abdurrahmanaydin5858/PCB/README.md

# PCB
PCB_PROJECTS
The repo is about to my currrent and past projecy repo.
