abdurrahmanaydin5858/PCB/CONTROLBOARD(FAZ2)/Project Input/BLOCK.PNG

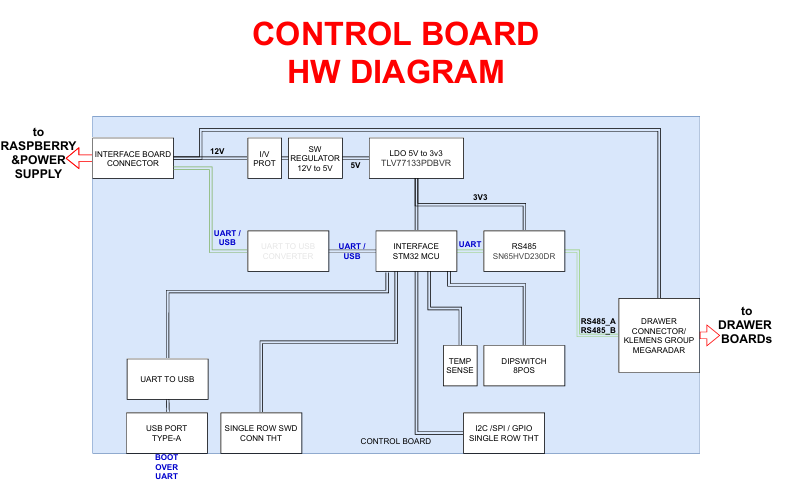
CONTROLBOARD(FAZ2)/Project Input/BLOCK.PNG
