abdurrahmanaydin5858/PCB/CONTROLBOARD(FAZ2)/Project Input/diagram.png

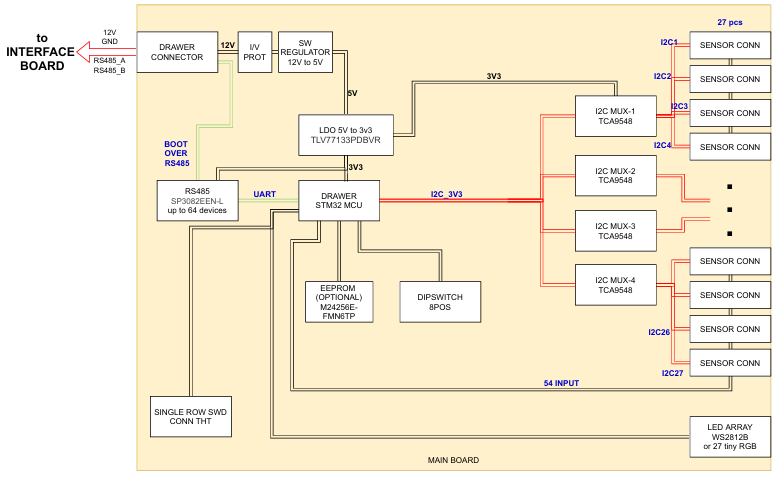
CONTROLBOARD(FAZ2)/Project Input/diagram.png
