abdurrahmanaydin5858/PCB/CONTROLBOARD(FAZ2)/Project Input/TCA_ADDRESS.PNG

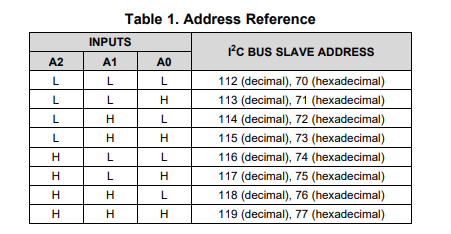
CONTROLBOARD(FAZ2)/Project Input/TCA_ADDRESS.PNG
