abdurrahmanaydin5858/PCB/CONTROLBOARD(FAZ2)/Project Input/TMP100.PNG

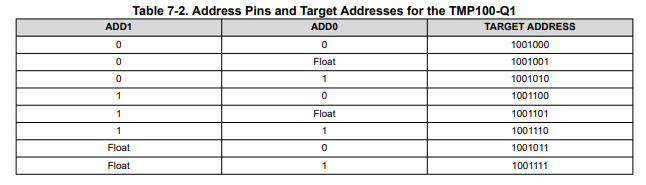
CONTROLBOARD(FAZ2)/Project Input/TMP100.PNG
