abdurrahmanaydin5858/PCB/MAINBOARD(FAZ2)/Production Files/Assembly/BOM_MAINBOARD.xlsx

Quantity | Designator | Part Number | Description
84 | R1, R2, R3, R4, R6, R8, R10, R11, R12, R13, R14, R15, R16, R18, R20, R22, R23, R24, R25, R26, R27, R28, R30, R32, R34, R35, R36, R37, R38, R39, R40, R42, R44, R46, R47, R48, R49, R50, R51, R52, R54, R56, R58, R59, R60, R61, R62, R63, R64, R66, R68, R70, R71, R72, R73, R74, R75, R76, R78, R80, R82, R83, R84, R85, R86, R87, R88, R90, R92, R94, R95, R96, R97, R98, R99, R100, R102, R104, R106, R107, R108, R147, R148, R158 | RMCF0402JT220R | Generic Chip Res 220R
51 | C1, C2, C3, C4, C8, C10, C12, C14, C16, C17, C18, C19, C20, C22, C23, C24, C25, C26, C27, C28, C29, C32, C33, C34, C40, C41, C42, C43, C44, C45, C46, C47, C48, C49, C50, C51, C52, C53, C54, C55, C56, C57, C58, C59, C60, C61, C62, C63, C64, C65, C66 | CL05B104KP5NNNC | 100nF 0402 Ceramic Capacitor
35 | R110, R112, R114, R115, R117, R119, R121, R123, R125, R127, R128, R130, R134, R135, R136, R137, R138, R139, R140, R141, R142, R143, R144, R145, R146, R149, R160, R161, R162, R163, R164, R165, R166, R167, R168 | RMCF0402JT2K20 | Generic Chip Res 2k2
28 | J1, J2, J3, J4, J5, J6, J7, J8, J9, J10, J11, J12, J13, J14, J15, J16, J17, J18, J19, J20, J21, J22, J23, J24, J25, J26, J27, J_BOS | 009159006651906 | CONN EDGE DUAL FMALE 6POS 0.024
28 | Q1, Q2, Q3, Q4, Q5, Q6, Q7, Q8, Q9, Q10, Q11, Q12, Q13, Q14, Q15, Q16, Q17, Q18, Q19, Q20, Q21, Q22, Q23, Q24, Q25, Q26, Q27, Q28 | GSF3407 | P-Channel 30 V 4.1A (Ta) 1.2W (Ta) Surface Mount SOT-23
28 | R5, R7, R9, R17, R19, R21, R29, R31, R33, R41, R43, R45, R53, R55, R57, R65, R67, R69, R77, R79, R81, R89, R91, R93, R101, R103, R105, R153 | RMCF0402JT100K | Generic Chip Res 158k
27 | LED1, LED2, LED3, LED4, LED5, LED6, LED7, LED8, LED9, LED10, LED11, LED12, LED13, LED14, LED15, LED16, LED17, LED18, LED19, LED20, LED21, LED22, LED23, LED24, LED25, LED26, LED27 | IN-PI22TAT5R5G5B | ADDRESS LED DISCRETE SERIAL RGB
7 | C5, C6, C7, C9, C11, C13, C15 | CL10A225KP8NNNC | 2.2uF 0603 Ceramic Capacitor
4 | U1, U2, U3, U4 | TCA9548APWR | IC BUS SWITCH 1 X 8:1 24TSSOP
3 | C35, C38, C39 | CL21A106KOQNNNE | 10uF 0805 Ceramic Capacitor
3 | D4, D5, D6 | HSMM-C170
3 | R152, R155, R157 | RMCF0402FT3K00 | Generic Chip Res 3k0
2 | C21, C37 | CL10A475KP8NNNC | 4,7uF 0603 Ceramic Capacitor
2 | C30, C31 | CC0402JRNPO9BN180 | 18pF 0402 Ceramic Capacitor
2 | D1, D2 | SMF16CA | Unidirectional TVS DIODE 200W 16V-17.8V SOD-123
2 | J_EXTRA, PROG | 125SH-B-05-TS | CONN HEADER VERT 5POS 1.25MM
1 | C36 | CC0402JRNPO9BN101 | 100pF 0402 Ceramic Capacitor
1 | D3 | SMF13A | TVS DIODE 200W 14.4V-15.9V SOD-123
1 | DEVICE_ID | 219-8LPST | Dip Switch SPST 8 Position Surface Mount Slide (Standard) Actuator 100mA 20VDC
1 | INPUT | B4B-XH-A | CONN HEADER VERT 4POS 2.5MM
1 | L1 | MPZ1608S221ATA00 | Generic SMD IND/BEAD
1 | L2 | BMRB00060630100MA1 | FIXED IND 10UH 4A 68 MOHM SMD
1 | R150 | MF72-005D9 | Inrush Current Limiter 5 Ohms ±20% 3 A
1 | R151 | RMCF0402FT158K | Generic Chip Res 158k
1 | R154 | RMCF0402JT30K0 | Generic Chip Res 30k
1 | R156 | RMCF0402FT2K00 | Generic Chip Res 2k0
1 | U5 | STM32H563ZIT6 | ARM® Cortex®-M33 STM32H5 Microcontroller IC 32-Bit 250MHz 2MB (2M x 8) FLASH 144-LQFP (20x20) )
1 | U6 | M24256E-FMN6TP | IC EEPROM 256KBIT I2C 1MHZ 8SO
1 | U7 | SP3082EEN-L | 1/1 Transceiver Half RS422, RS485 8-SOIC
1 | U8 | AP63200WU-7 | IC REG BUCK ADJ 2A TSOT23-6 3.8V to 32V
1 | U9 | AMS1117-ADJ | IC LDO REG ADJ 1A SOT223
