abdurrahmanaydin5858/PCB/CONTROLBOARD(FAZ2)/finalRevisions_kb.txt

1- Boyut 10x10 (EMT ile check edilecek)   tamamlandı
2- 4 X rs485 portları :  Megaradar 14.204 MODEL TERMİNAL BLOCK 
3- 1 adet POWER PORT : Megaradar 12.353 3 pin
4- 1 adet USB PORT : CONNFLY RA Dişi
5- 6 pinli ALARM PORT : 6 pinli MEGARADAR. 1,2,3 HS SW (12V250ma). 4 -> V(-)
6- Montaj delikleri merkezden 5.2mm uzaklıkta 4 / 6    -------eklendi 6. eklenen çok mantıklı gelmedi yer kalmayacak gibi?
7- Dizgi tek tarafta olacak
8- Giriş Çıkışlara korumalar ------eklenecek eklendi  output koruması yok
9- Alarm güçleri dısarıdan gelecek. sadece anahtarlama yapılacak -----  eklendi koruma nasıl olacak sadece giriş mi? 
10- EEPROM eklenecek -------(var zaten ne ile değişecek)   mainboard daki ile aynı

11- İşlemci : STM32F405RGT6 olacak (değiştirildi)
12- Extra Service Uart ve I2C portu olacak  -------- yarın bakılacak
13- Sistemle haberleşme icin yedek olarak UART portu olacak (MEGARADAR 3-4 pin)( yedek UART hattı pek mümkün görünmüyor.)
