abdurrahmanaydin5858/PCB/CONTROLBOARD(FAZ2)/CONTROLBAORD.pdf

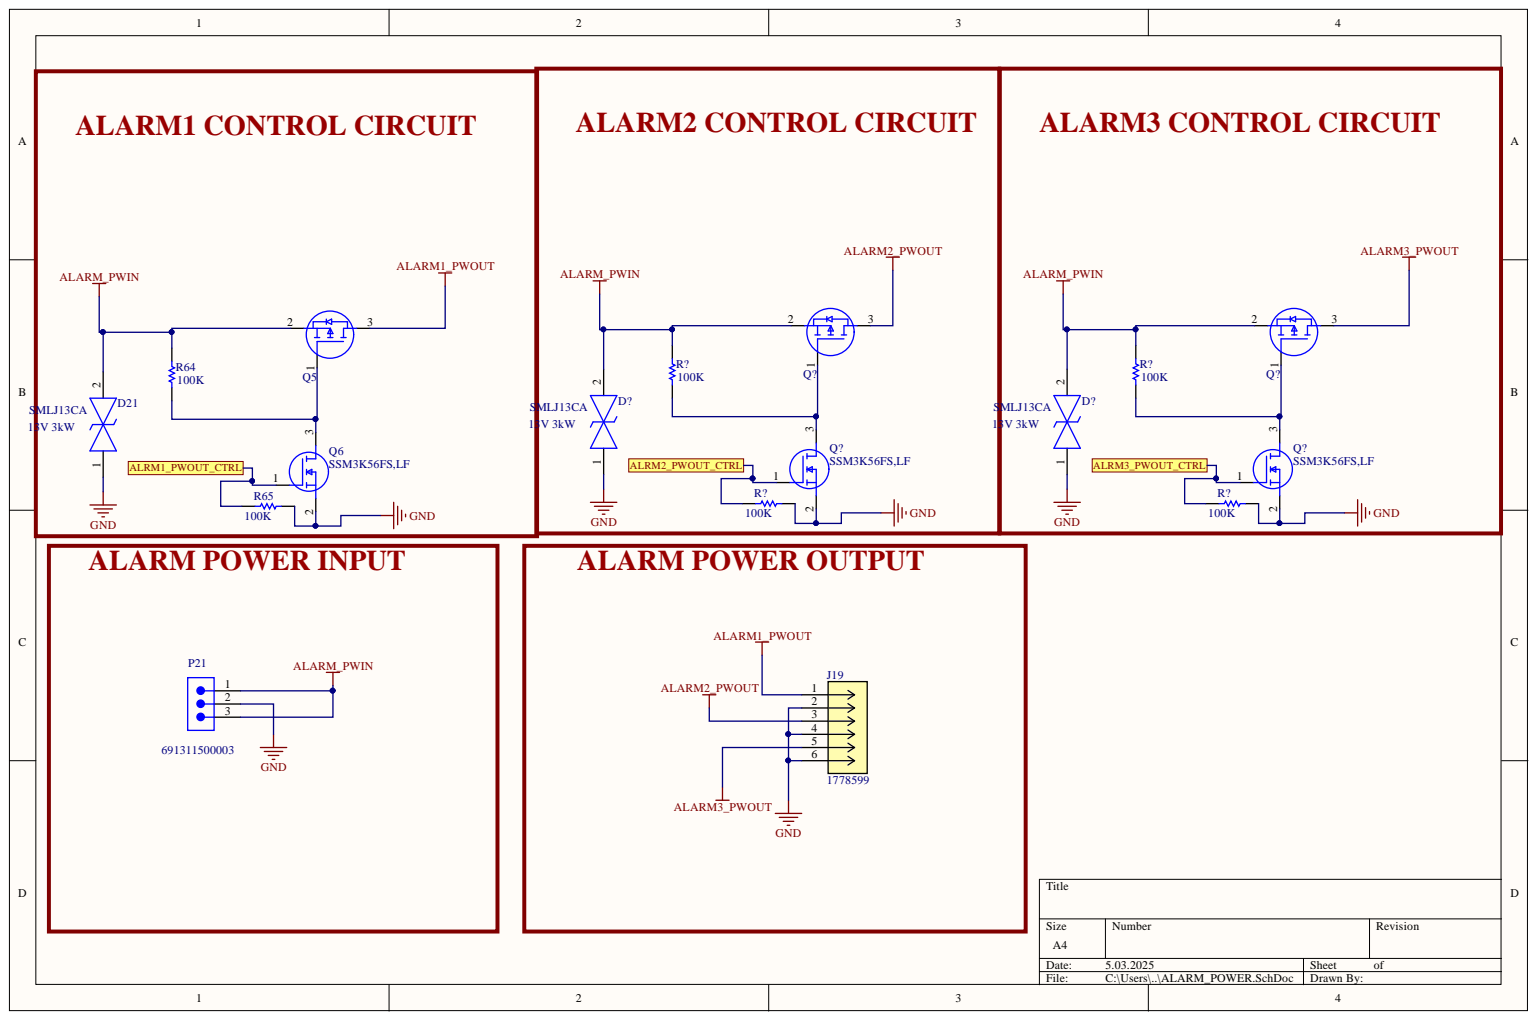
[picture p7: page 1]

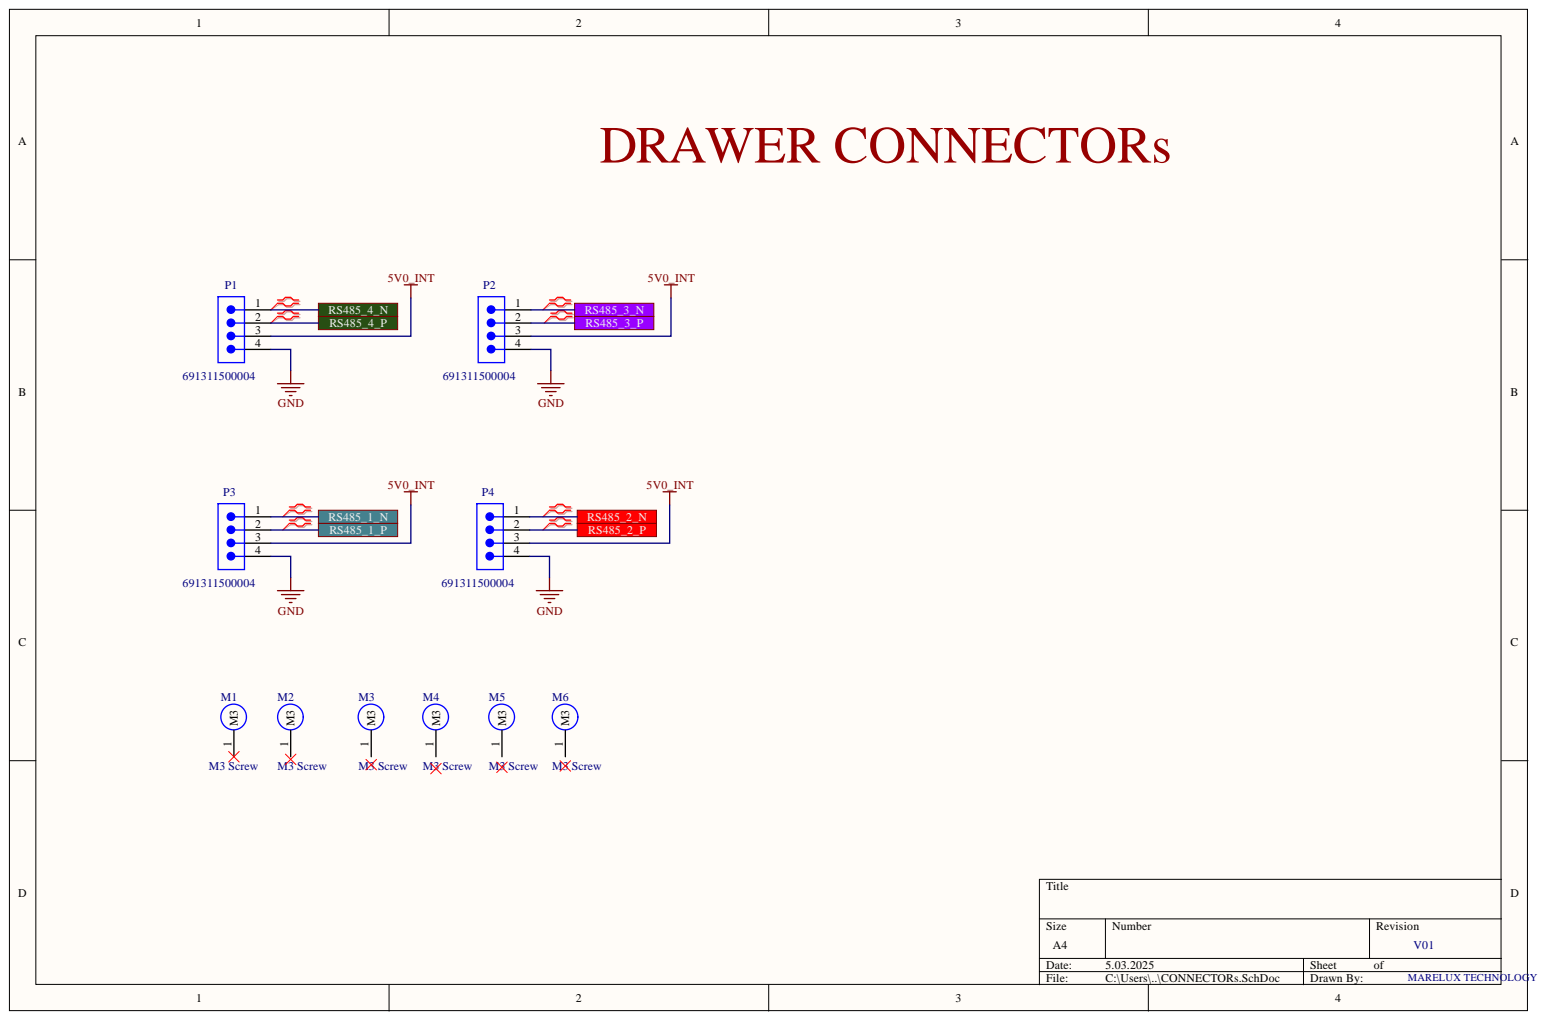
[picture p8: page 2]

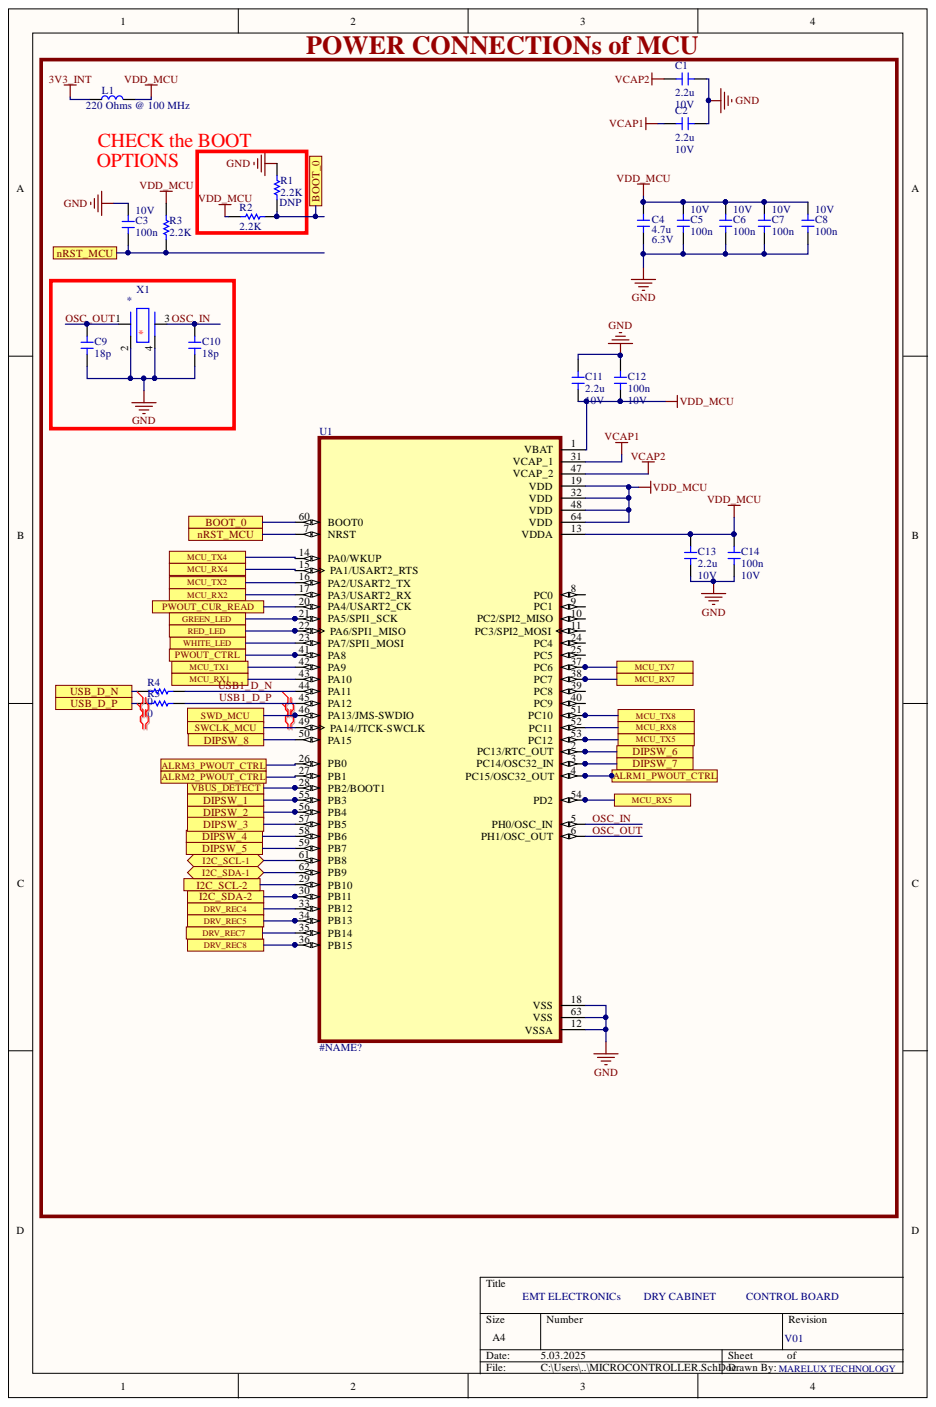
[picture p9: page 3]

POWER CONNECTIONs of MCU

MCU_RX4 | PA1/USART2_RTS 15
MCU_TX2 | PA2/USART2_TX 16

MCU_RX2 | PA4/USART2_CK 20
PWOUT_CUR_READ | PA5/SPI1_SCK 21 | GND
GREEN_LED | PA6/SPI1_MISO 22
RED_LED | PA7/SPI1_MOSI 23
WHITE_LED | PA8 41

MCU_RX1 USB1_D_N | | PA10 43 | MCU_RX7

USB_D_N | | PA11 44
USB_D_P | USB1_D_P | PA12 45

SWCLK_MCU | PA14/JTCK-SWCLK 49 PA15 50 | MCU_RX8

DIPSW_8 | PB0 26 | MCU_TX5

ALRM3_PWOUT_CTRL | PB1 27 | DIPSW_7
ALRM2_PWOUT_CTRL | PB2/BOOT1 28 | ALRM1_PWOUT_CTRL

VBUS_DETECT | PB3 55
DIPSW_2 | PB4 56 | OSC_IN
DIPSW_3 | PB5 57

DIPSW_4 DIPSW_5 | PB7 59

PB6 58 | OSC_OUT

I2C_SCL-2 | PB11 30
I2C_SDA-2 | PB12 33
DRV_REC4 | PB13 34
DRV_REC5 | PB14 35
DRV_REC7 | PB15 36

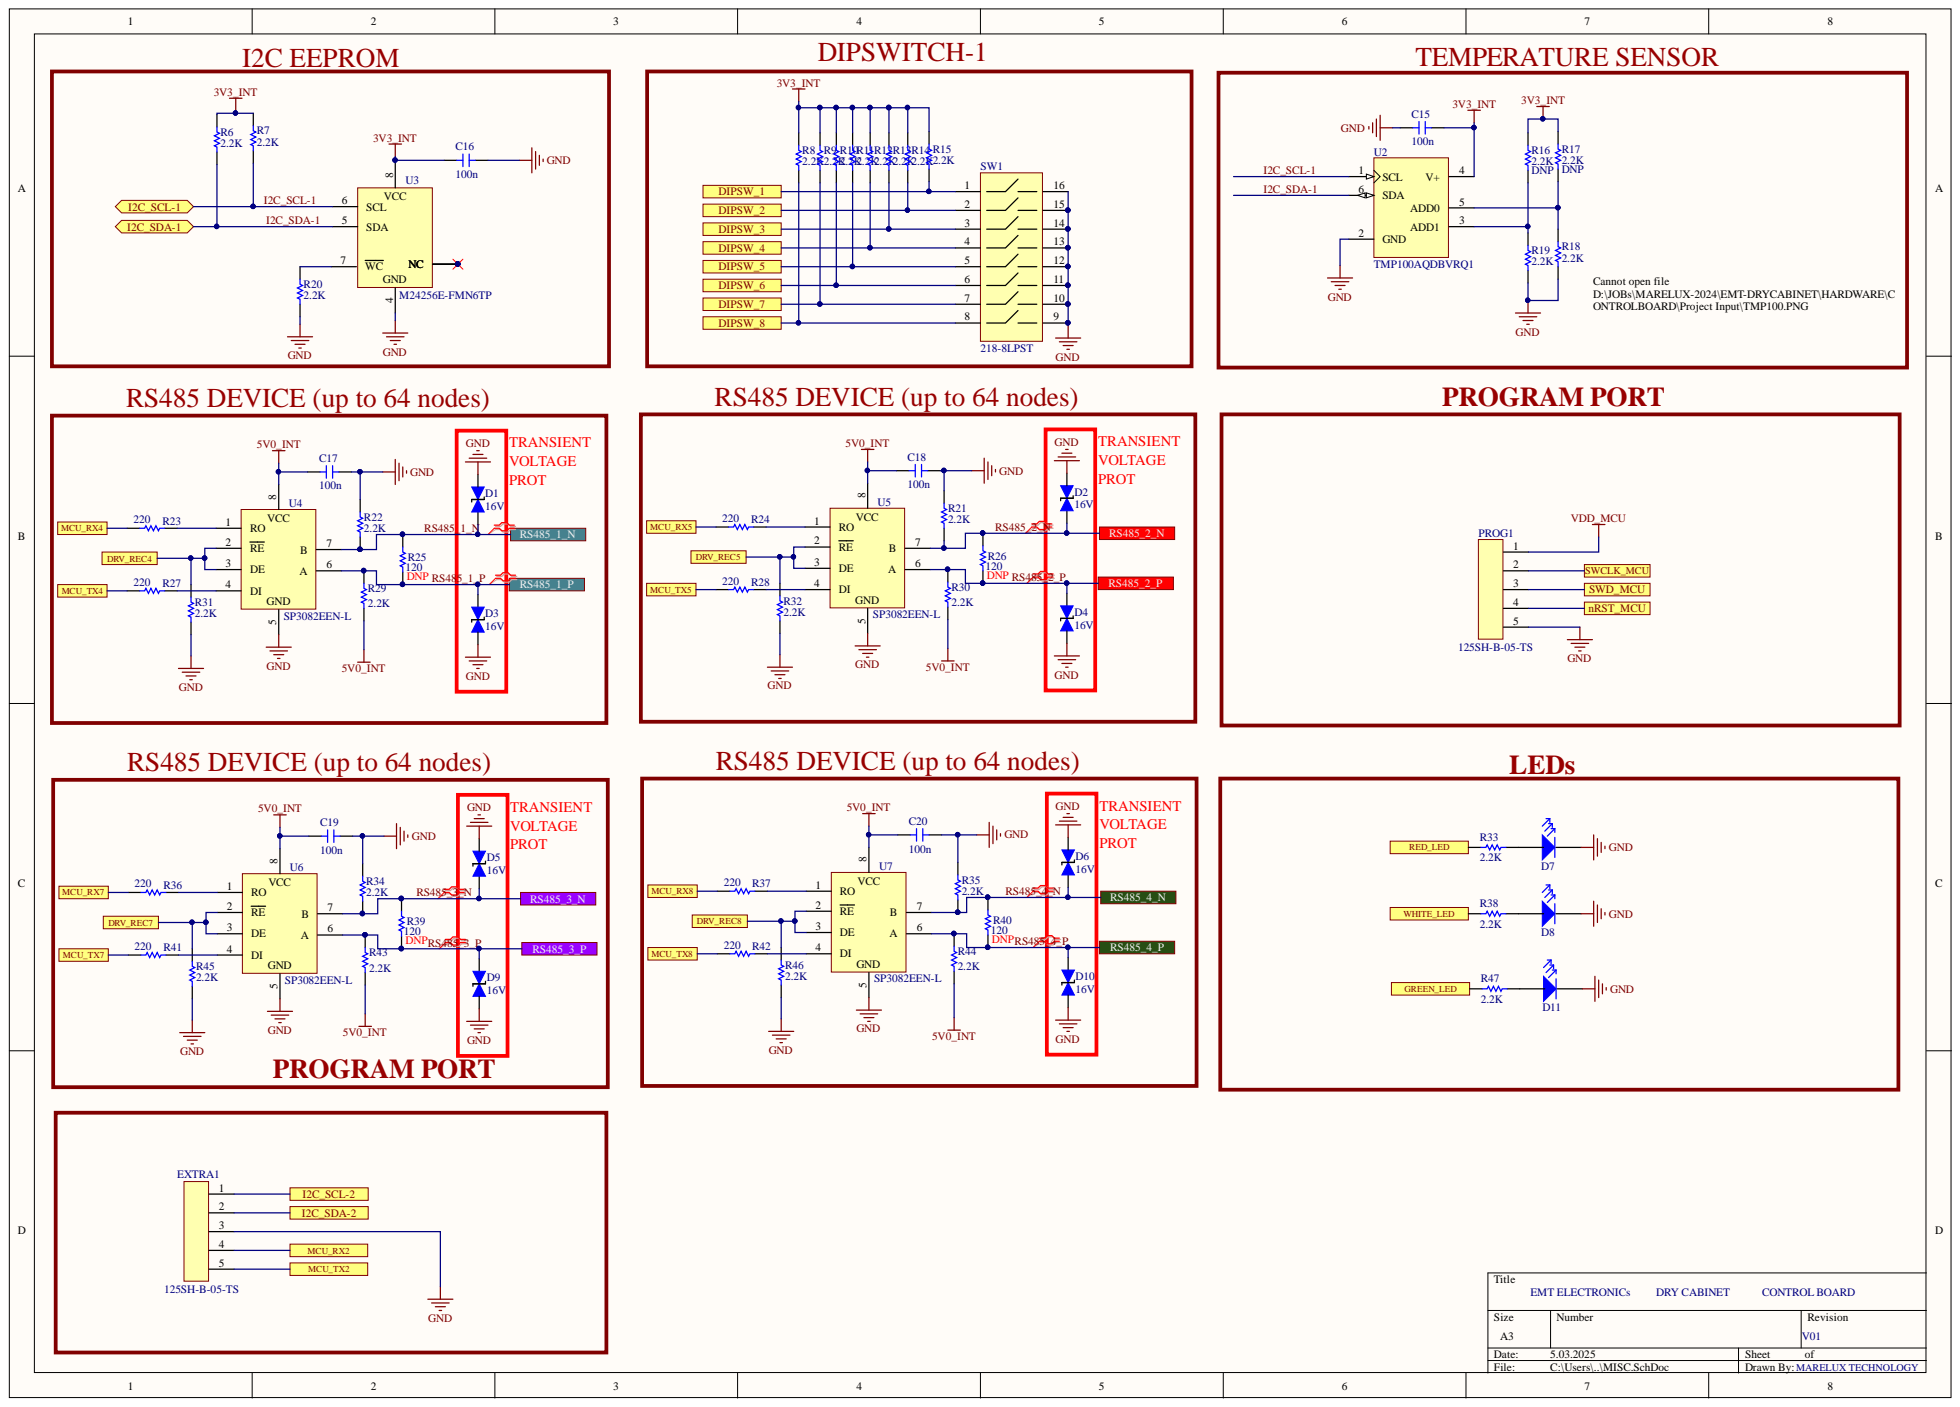
[picture p10: page 4]

DIPSW_4 | 5 | 12

6 | 11
7 | 10

Cannot open file
D:\JOBs\MARELUX-2024\EMT-DRYCABINET\HARDWARE\C
ONTROLBOARD\Project Input\TMP100.PNG

RS485 DEVICE (up to 64 nodes)

3 | I2C_SDA-2

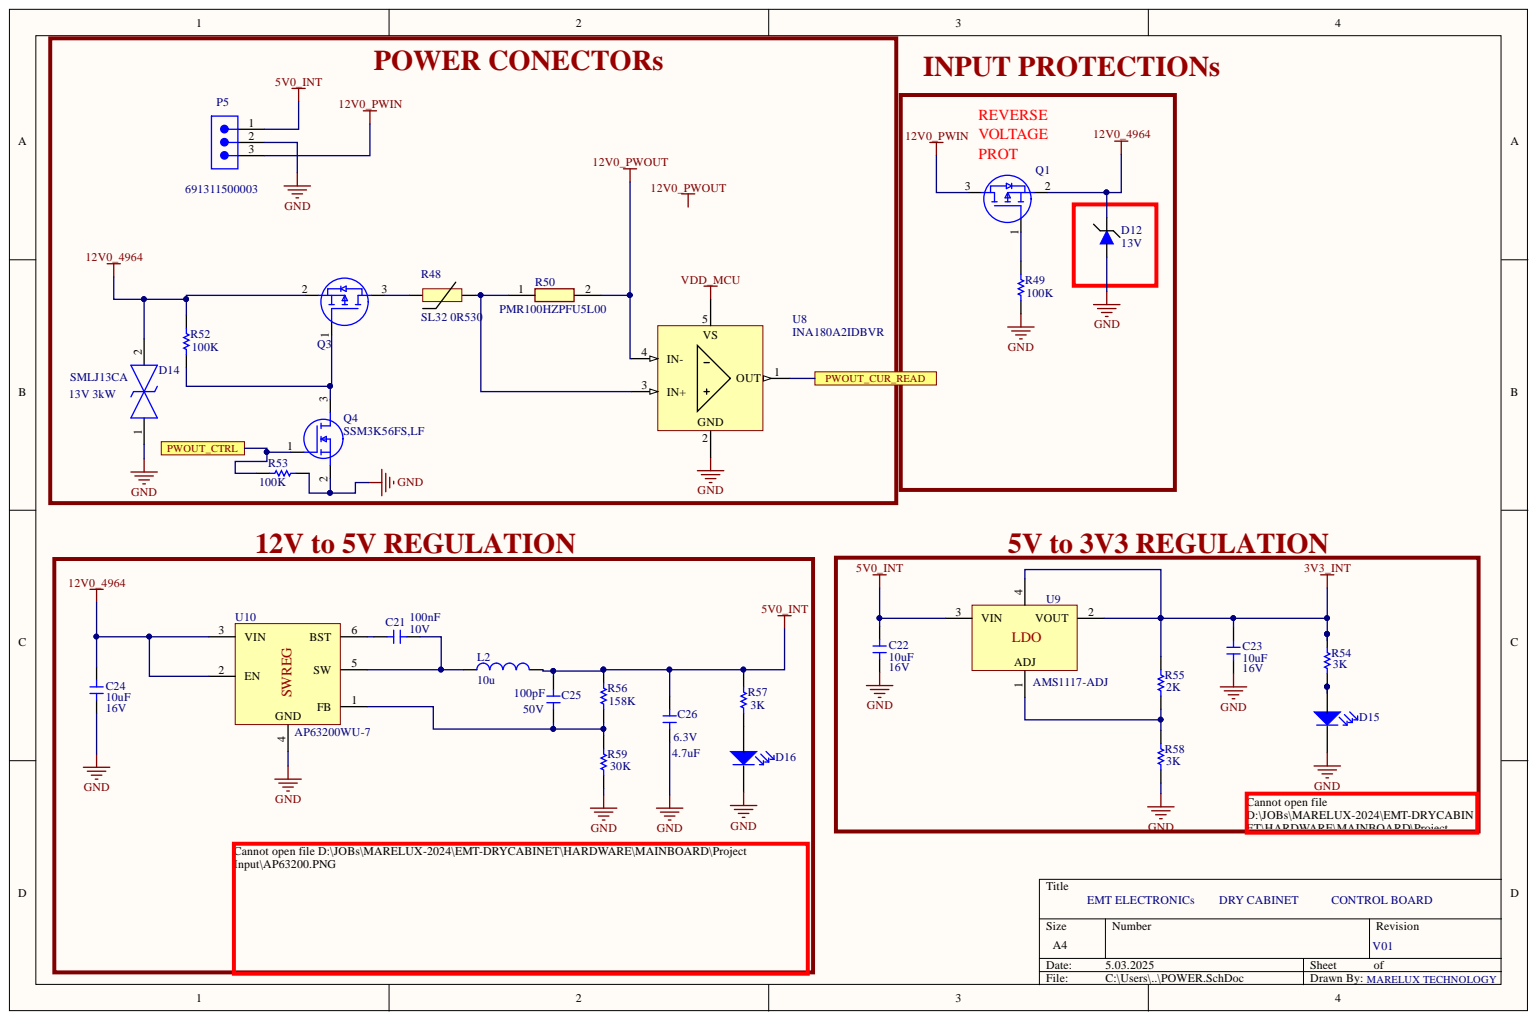
[picture p11: page 5]

Cannot open file
D:\JOBs\MARELUX-2024\EMT-DRYCABIN
ET\HARDWARE\MAINBOARD\Project

Cannot open file D:\JOBs\MARELUX-2024\EMT-DRYCABINET\HARDWARE\MAINBOARD\Project
Input\AP63200.PNG

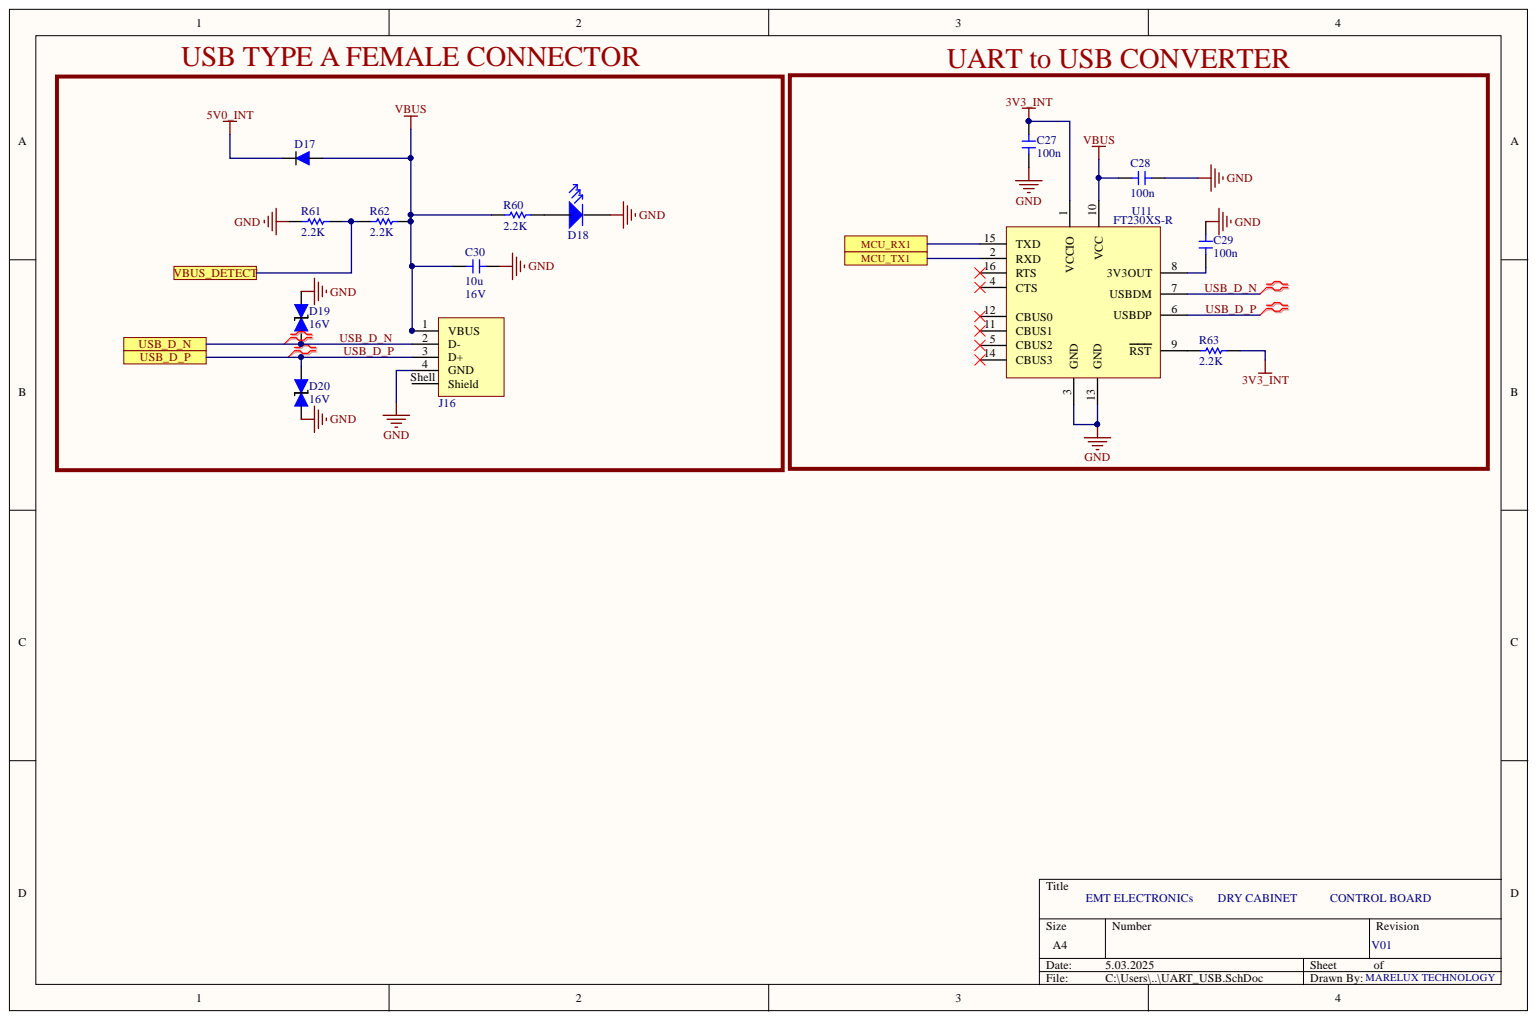
[picture p12: page 6]
