abdurrahmanaydin5858/PCB/MAINBOARD(FAZ2)/MAINBOARD.pdf

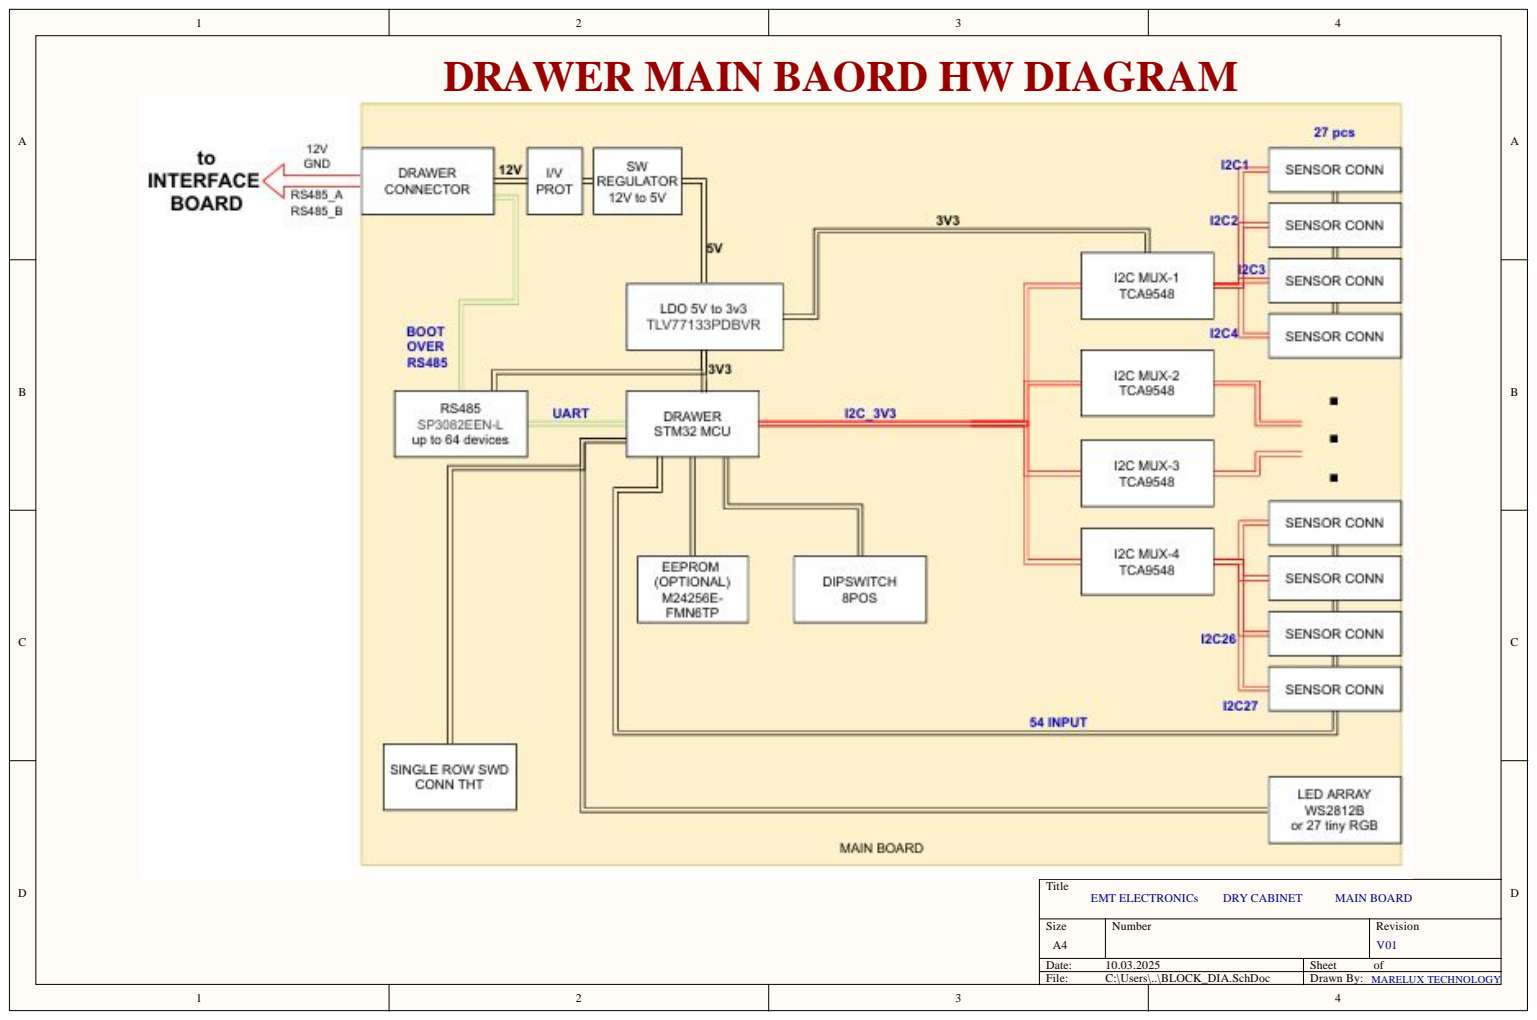
[picture p13: page 1]

DRAWER MAIN BAORD HW DIAGRAM

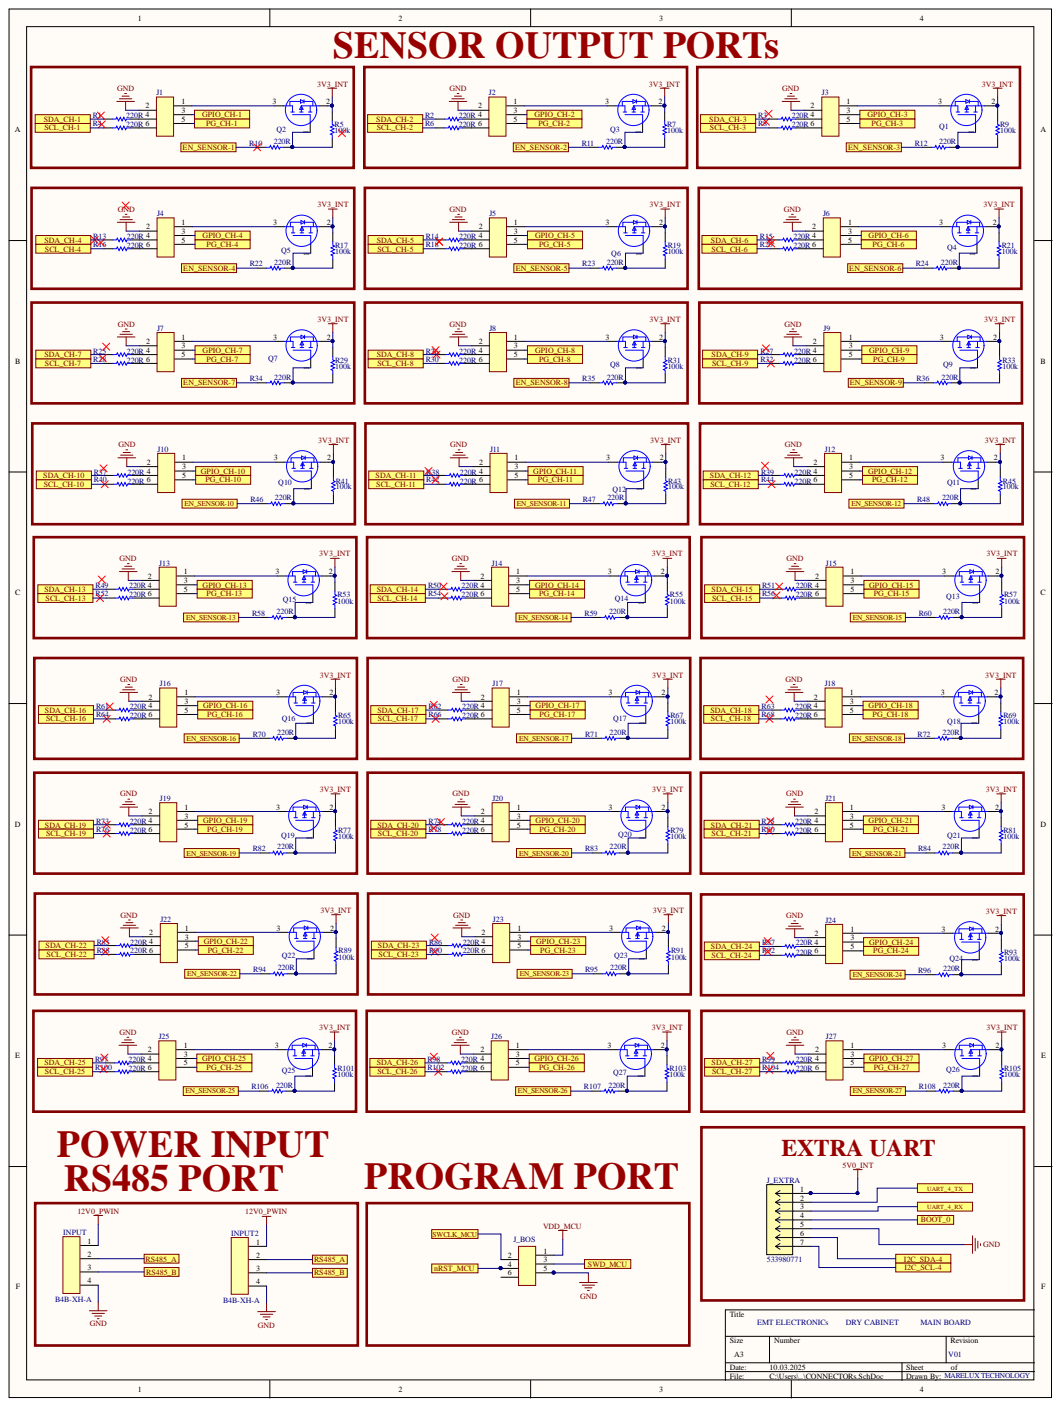
[picture p14: page 2]

File: C:\Users\..\CONNECTORs.SchDoc | Drawn By:

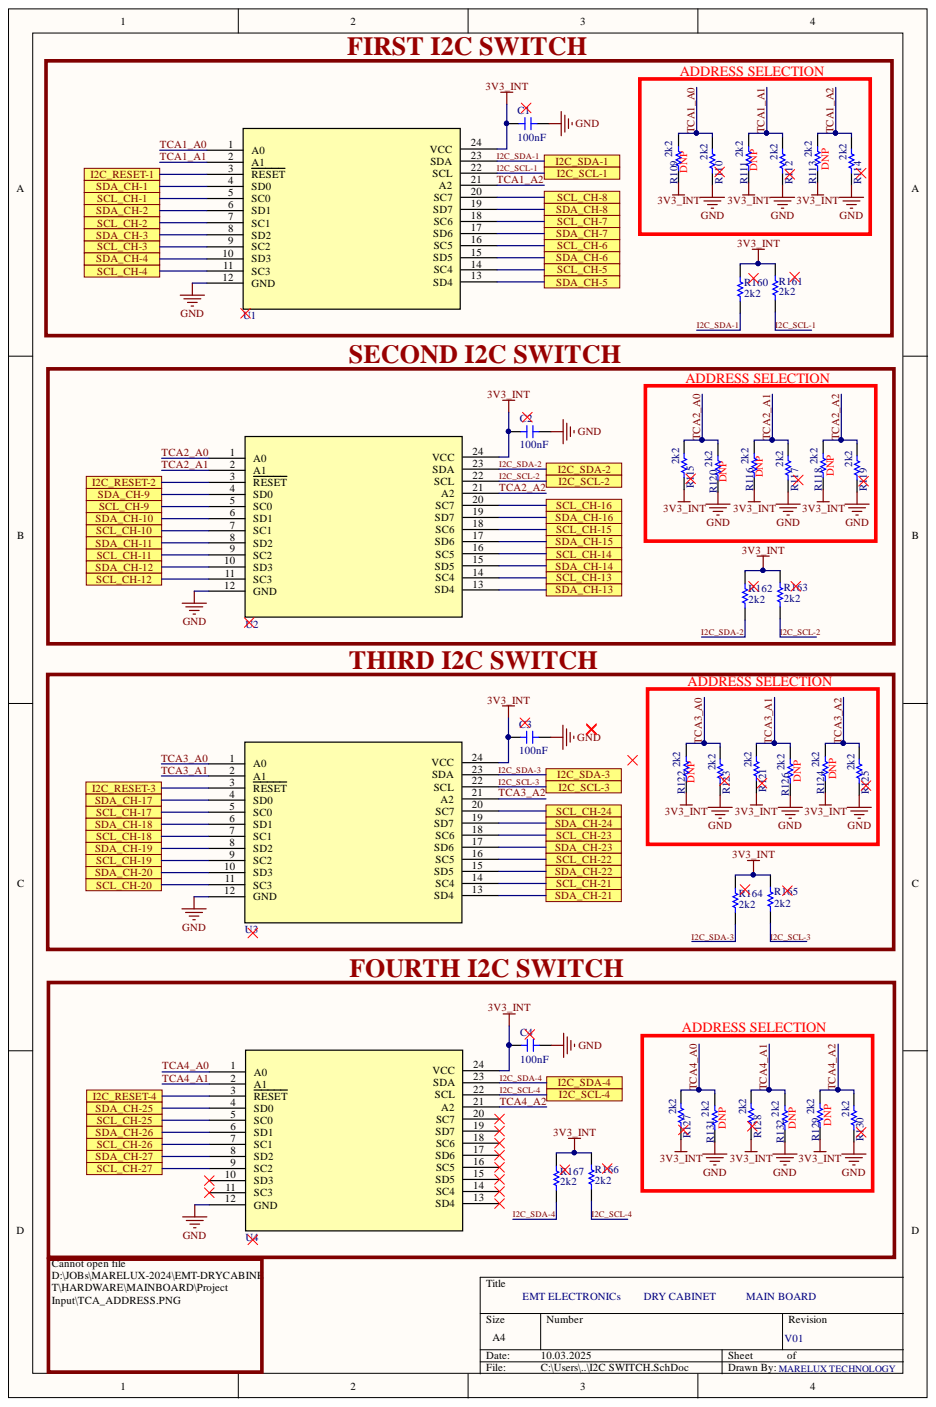
[picture p15: page 3]

I2C_RESET-1 | RESET 3 SD0 4 | I2C_SCL-1 TCA1_A2 | I2C_SCL-1

SCL_CH-2 | SCL_CH-7
SDA_CH-3 SCL_CH-3 | SD2 8 SC2 9 | SDA_CH-7 SCL_CH-6 | 3V3_INT

SDA_CH-4 | SD3 10 | SDA_CH-6
SCL_CH-4 | SC3 11 | SCL_CH-5

I2C_RESET-3 | RESET 3 SD0 4 | I2C_SCL-3 TCA3_A2 | I2C_SCL-3

SDA_CH-18 | SD1 6 | SDA_CH-24
SCL_CH-18 | SC1 7 | SCL_CH-23
SDA_CH-19 SCL_CH-19 | SD2 8 SC2 9 | SDA_CH-23 SCL_CH-22 | 3V3_INT

SDA_CH-20 | SD3 10 | SDA_CH-22
SCL_CH-20 | SC3 11 | SCL_CH-21

SCL_CH-25 | SD1 6
SDA_CH-26 | SC1 7
SCL_CH-26 | SD2 8

Cannot open file
D:\JOBs\MARELUX-2024\EMT-DRYCABINE
T\HARDWARE\MAINBOARD\Project
Input\TCA_ADDRESS.PNG

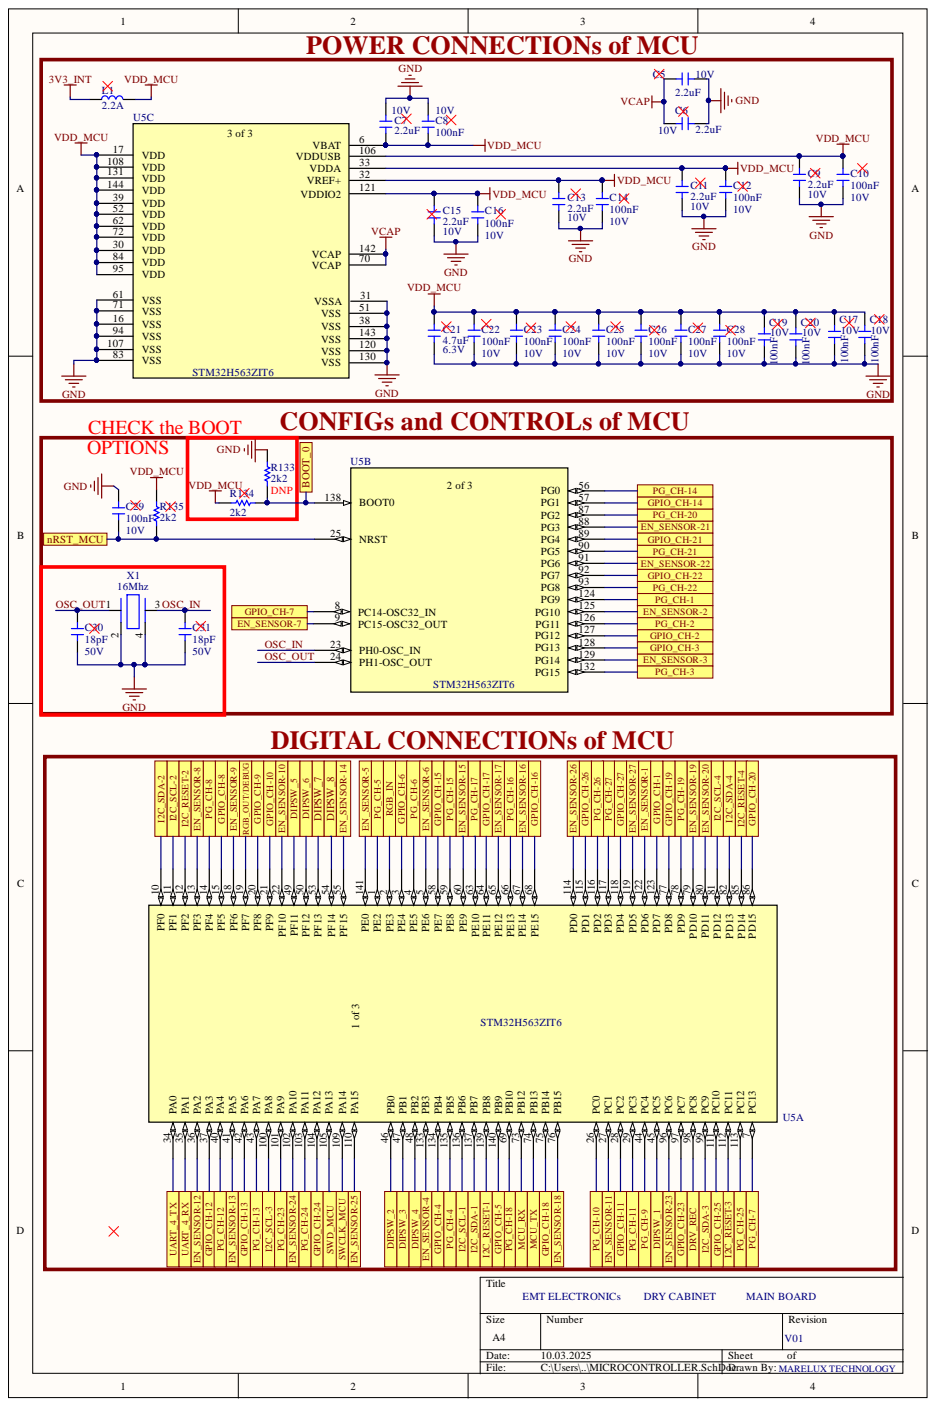
[picture p16: page 4]

POWER CONNECTIONs of MCU

CONFIGs and CONTROLs of MCU

DIGITAL CONNECTIONs of MCU

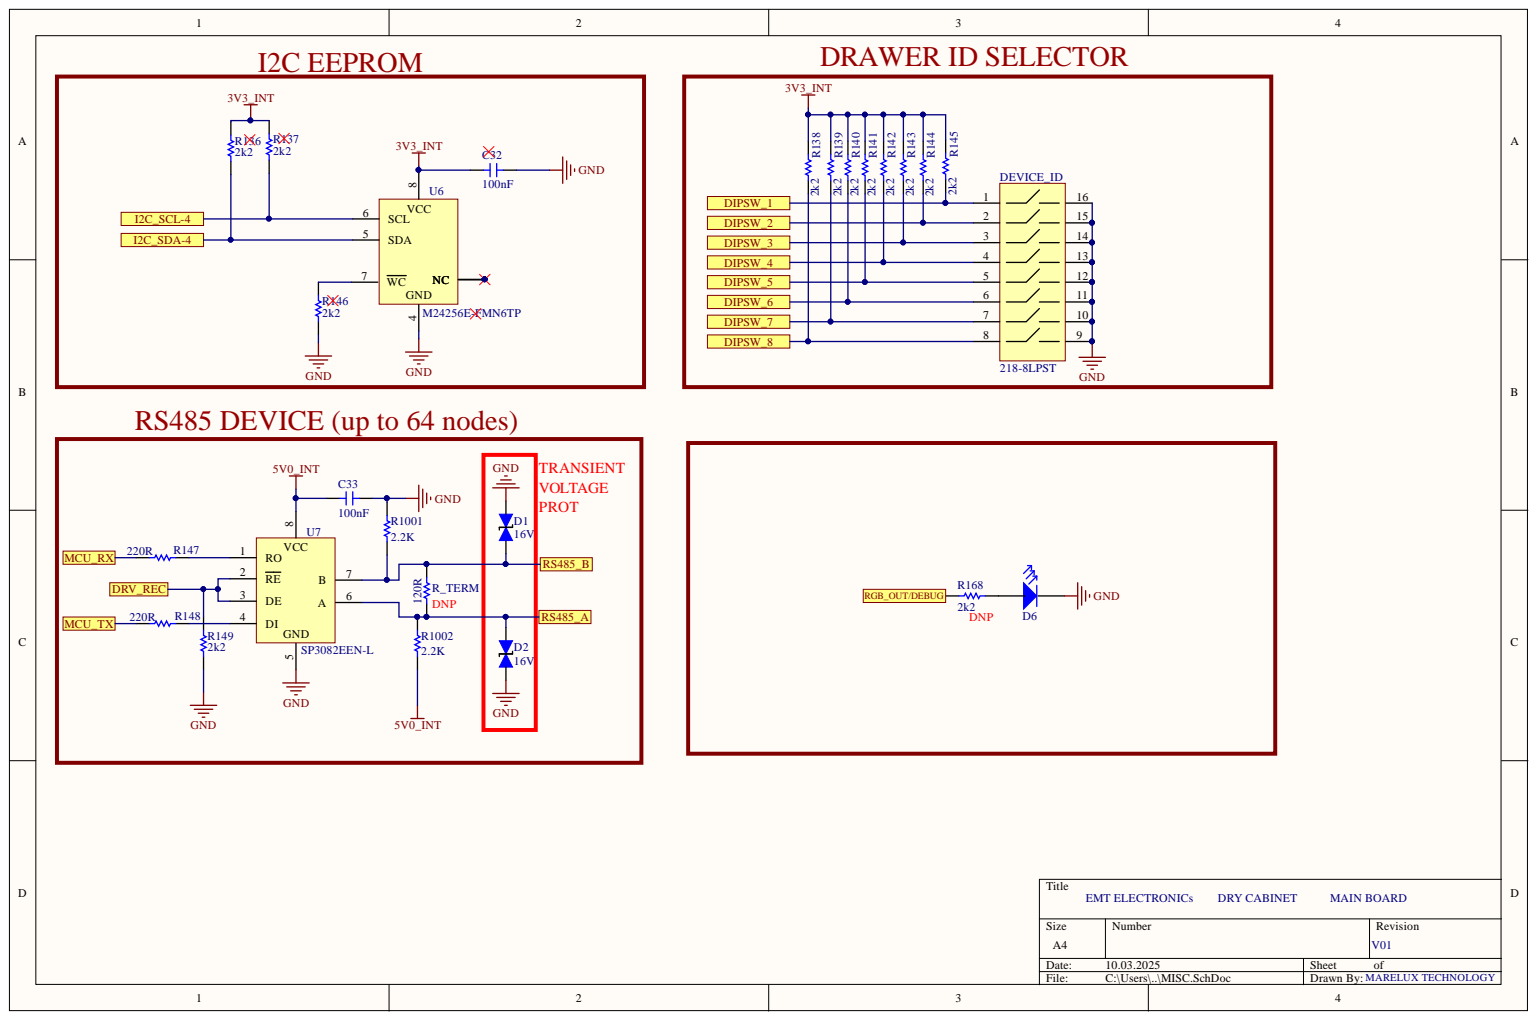
[picture p17: page 5]

4 | 13
5 | 12

7 | 10

RS485 DEVICE (up to 64 nodes)

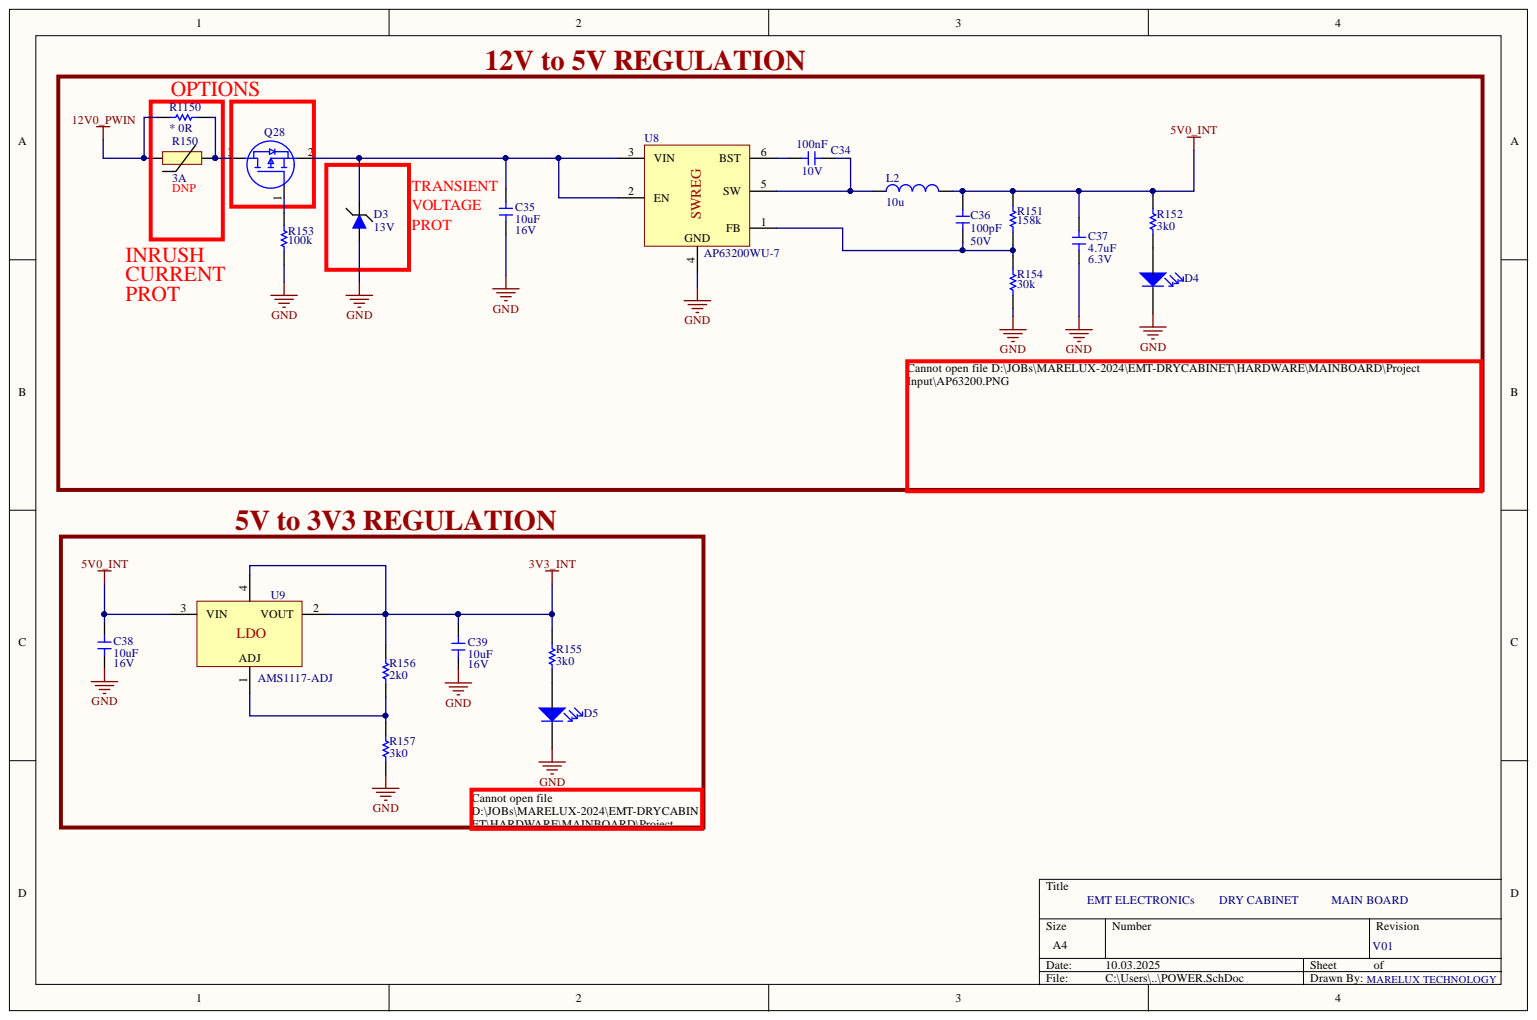
[picture p18: page 6]

Cannot open file D:\JOBs\MARELUX-2024\EMT-DRYCABINET\HARDWARE\MAINBOARD\Project
Input\AP63200.PNG

D:\JOBs\MARELUX-2024\EMT-DRYCABIN
ET\HARDWARE\MAINBOARD\Project

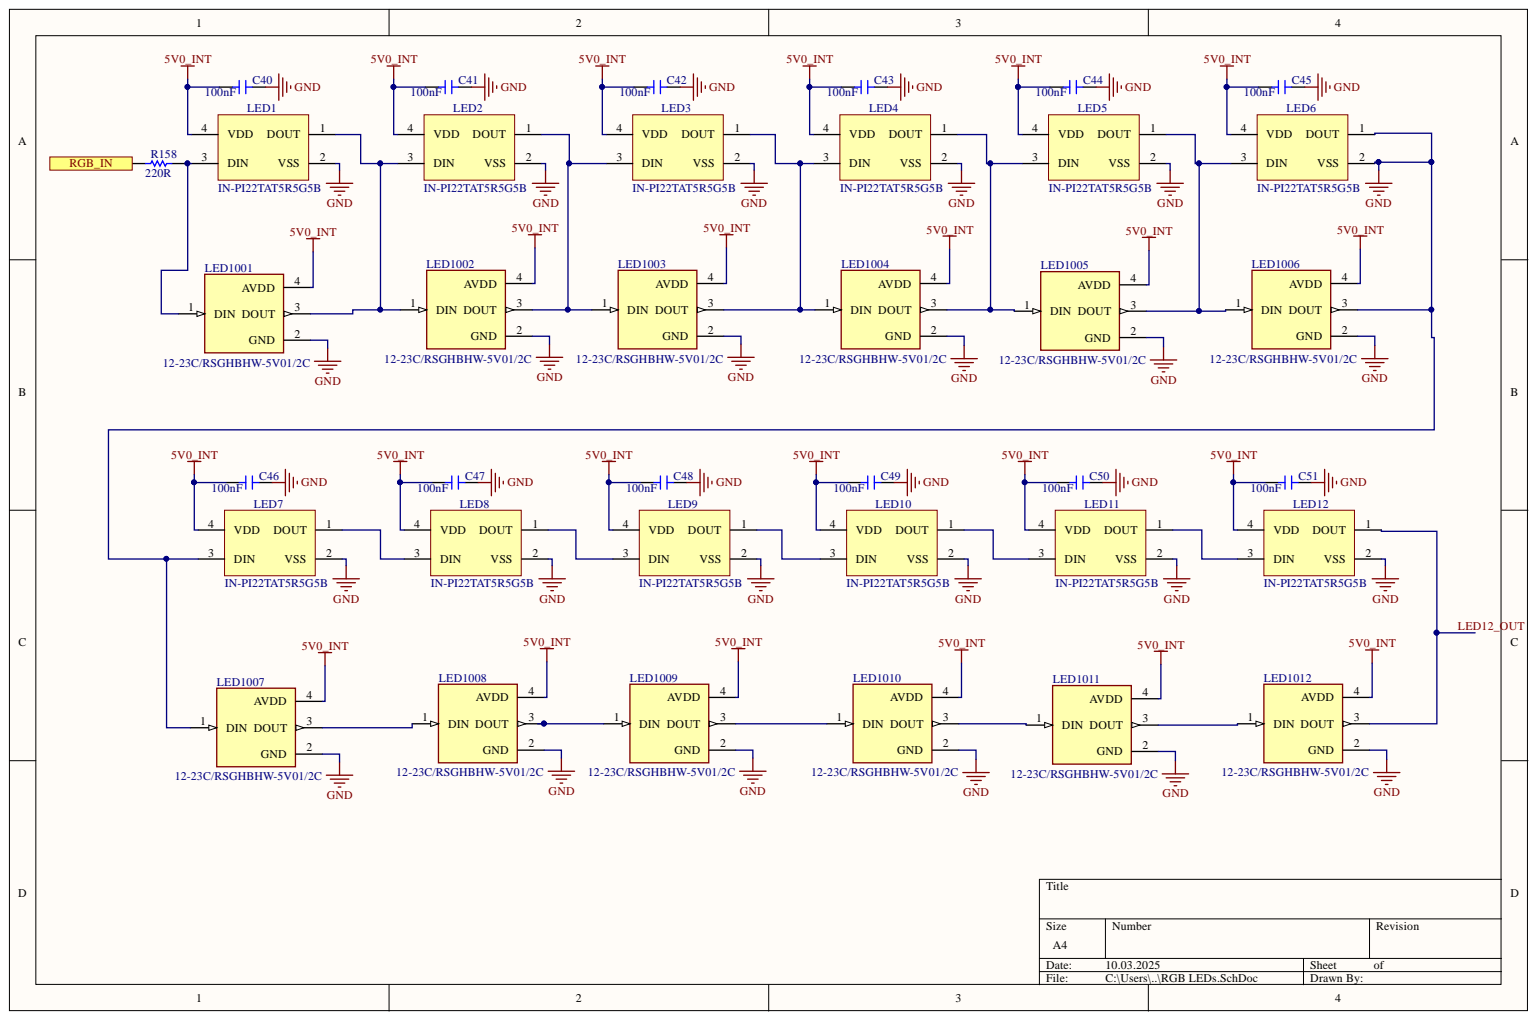
[picture p19: page 7]

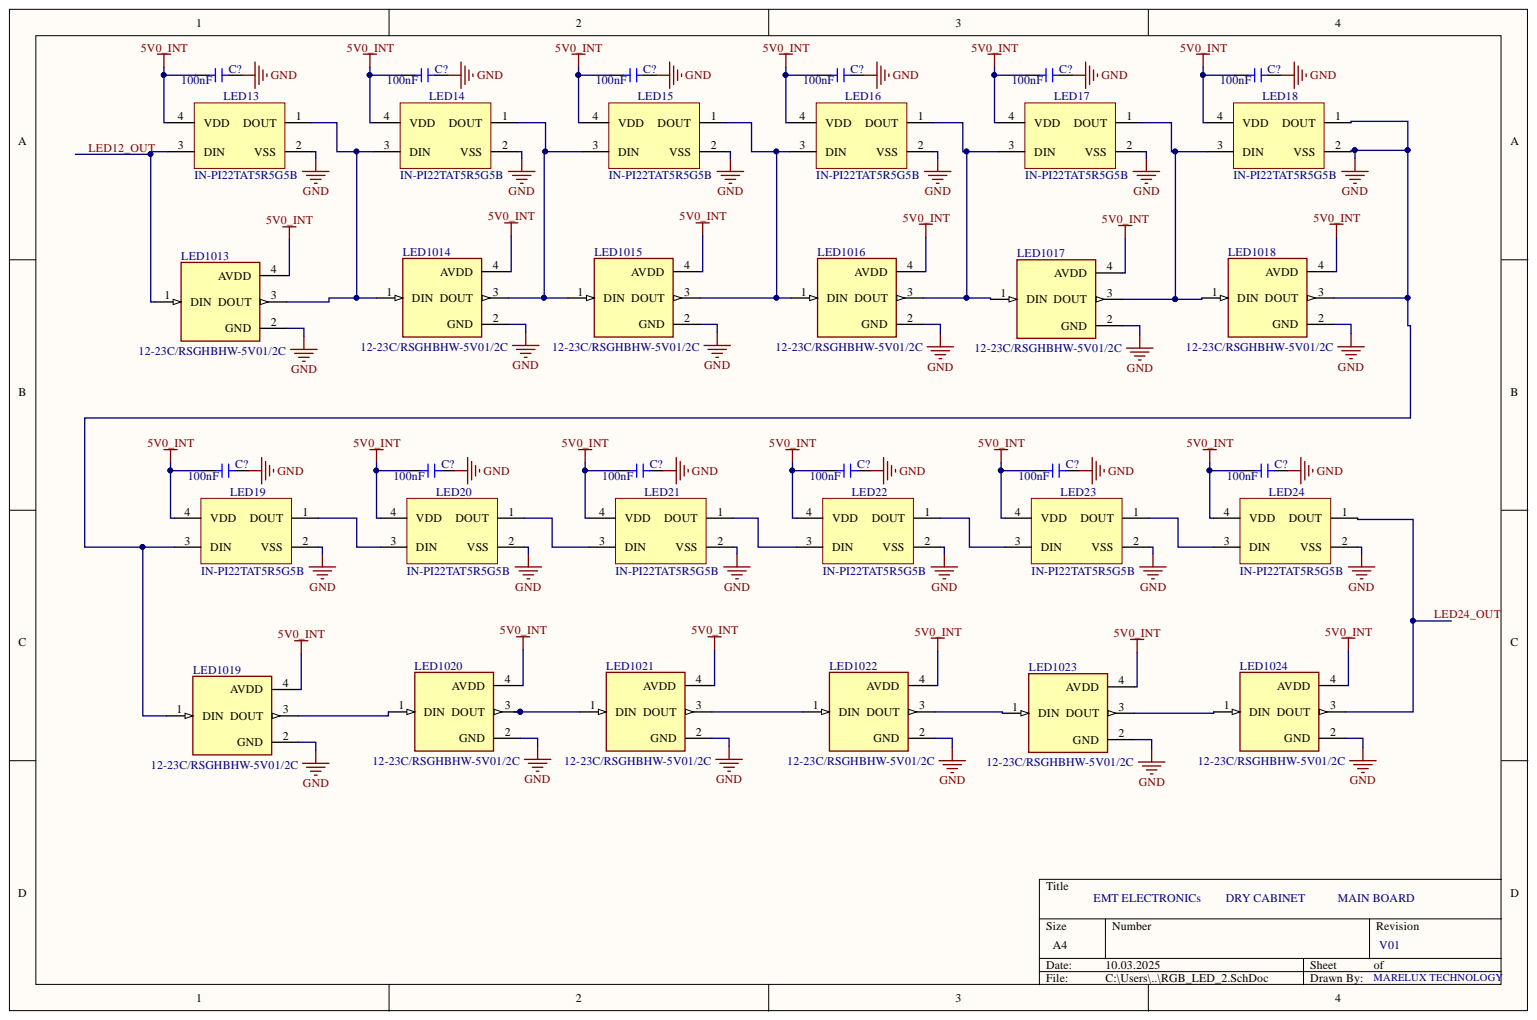
[picture p20: page 8]

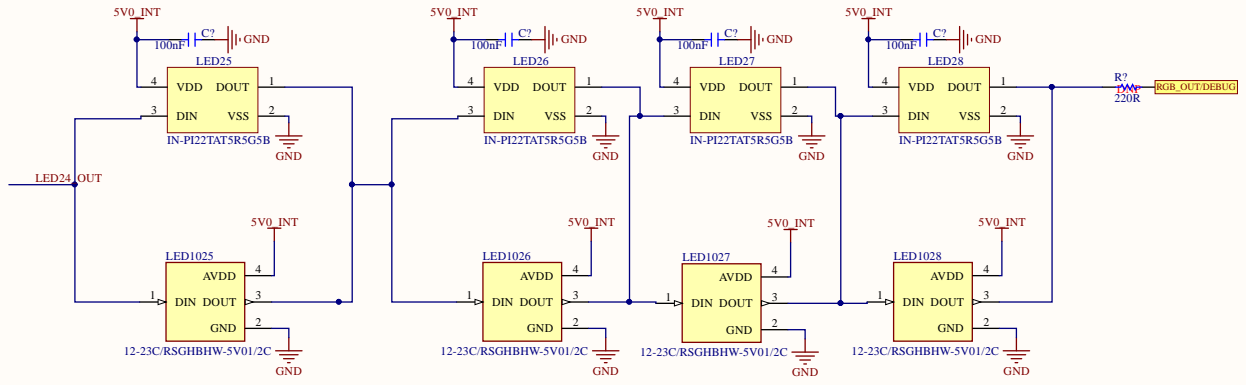
[picture p21: page 9]
