abdurrahmanaydin5858/PCB/(list of files, drawings)

Other design files:
CONTROLBOARD(FAZ2)/ALARM_POWER.SchDoc
CONTROLBOARD(FAZ2)/BLOCK_DIA.SchDoc
CONTROLBOARD(FAZ2)/CONNECTORs.SchDoc
CONTROLBOARD(FAZ2)/CONTROLBAORD.PrjPcb
CONTROLBOARD(FAZ2)/MICROCONTROLLER.SchDoc
CONTROLBOARD(FAZ2)/MISC.SchDoc
CONTROLBOARD(FAZ2)/POWER.SchDoc
CONTROLBOARD(FAZ2)/Project Input/pcb/pcb/PCB2.PcbDoc
CONTROLBOARD(FAZ2)/UART_USB.SchDoc
MAINBOARD(FAZ2)/BLOCK_DIA.SchDoc
MAINBOARD(FAZ2)/CONNECTORs.SchDoc
MAINBOARD(FAZ2)/I2C SWITCH.SchDoc
MAINBOARD(FAZ2)/MAINBOARD.PrjPcb
MAINBOARD(FAZ2)/MICROCONTROLLER.SchDoc
MAINBOARD(FAZ2)/MISC.SchDoc
MAINBOARD(FAZ2)/POWER.SchDoc
MAINBOARD(FAZ2)/RGB LEDs.SchDoc
MAINBOARD(FAZ2)/RGB_LED_2.SchDoc
MAINBOARD(FAZ2)/RGB_LED_3.SchDoc
