abdurrahmanaydin5858/PCB/(commit log)

2025-04-14 PCB ve Sematik
    Mainboard Sematik ve PCB
    [BLOCK_DIA.SchDoc, BOM_MAINBOARD.xlsx, CONNECTORs.SchDoc, I2C SWITCH.SchDoc, MAINBOARD.PrjPcb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]
2025-05-04 control board
    Control board last design
    [ALARM_POWER.SchDoc, BLOCK_DIA.SchDoc, CONNECTORs.SchDoc, CONTROLBAORD.PrjPcb, MICROCONTROLLER.SchDoc, MISC.SchDoc, PCB2.PcbDoc, POWER.SchDoc]
